Mandragore-ai/fiducial-dice-research/assets/APERCU_8_DES.png

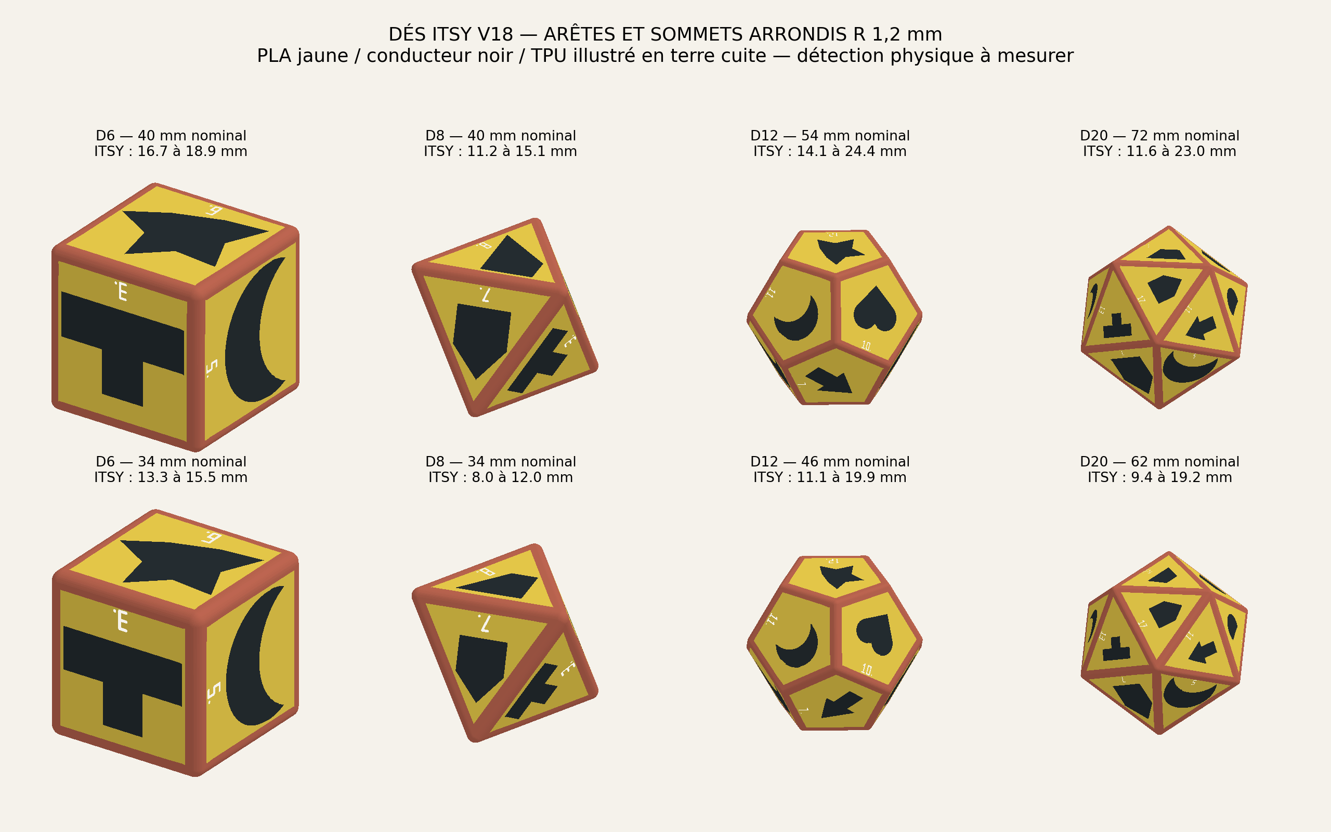
assets/APERCU_8_DES.png
