Mandragore-ai/fiducial-dice-research/docs/face-maps/V18_D6_34_A_FACES.png

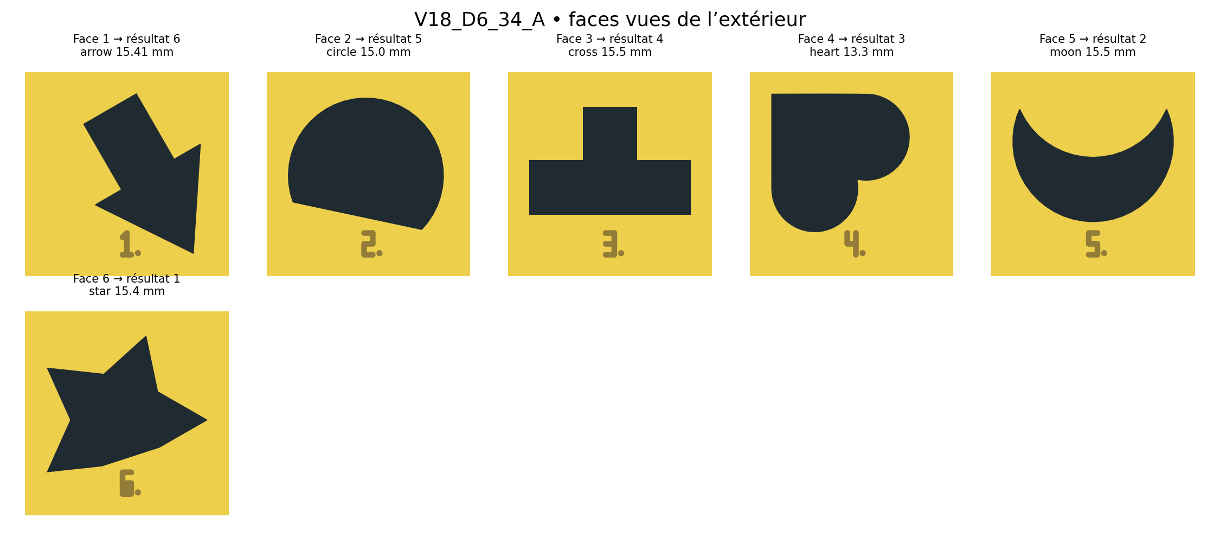
docs/face-maps/V18_D6_34_A_FACES.png
