Mandragore-ai/fiducial-dice-research/docs/face-maps/V18_D8_34_A_FACES.png

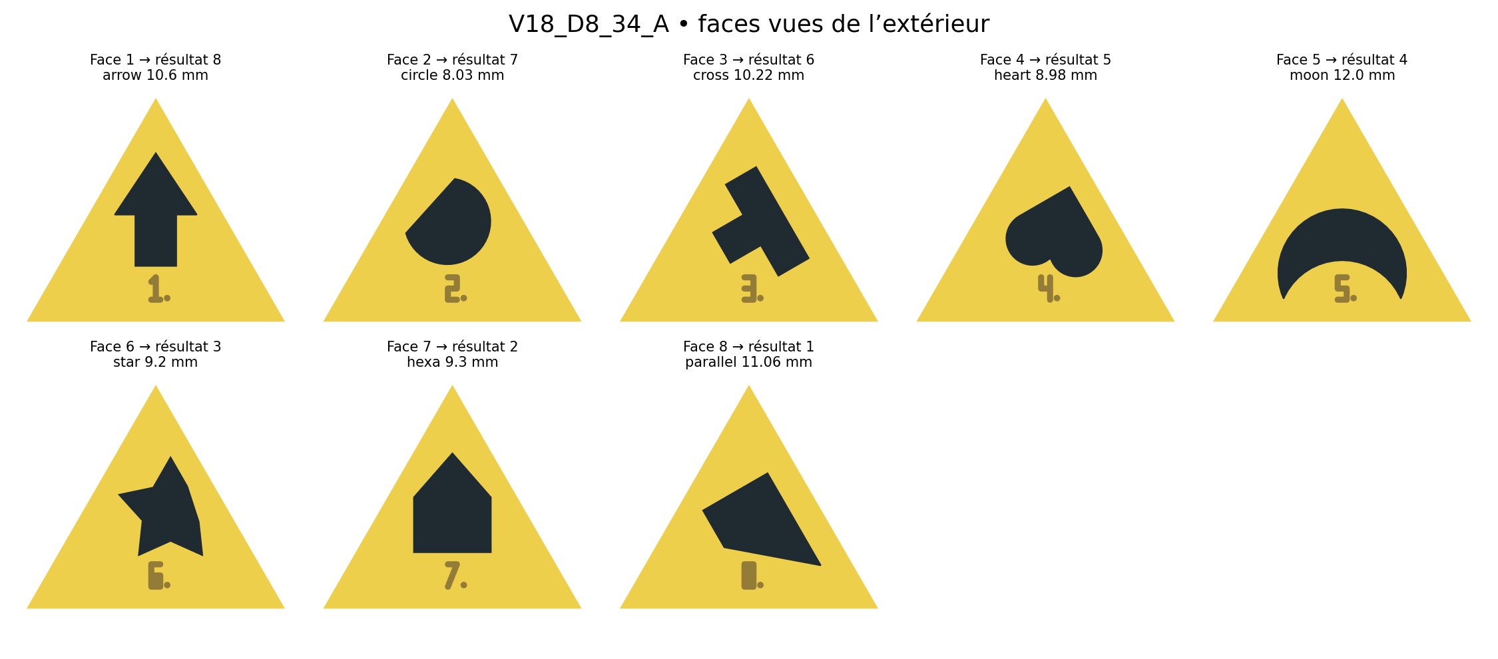
docs/face-maps/V18_D8_34_A_FACES.png
