Mandragore-ai/fiducial-dice-research/docs/face-maps/V18_D12_46_A_FACES.png

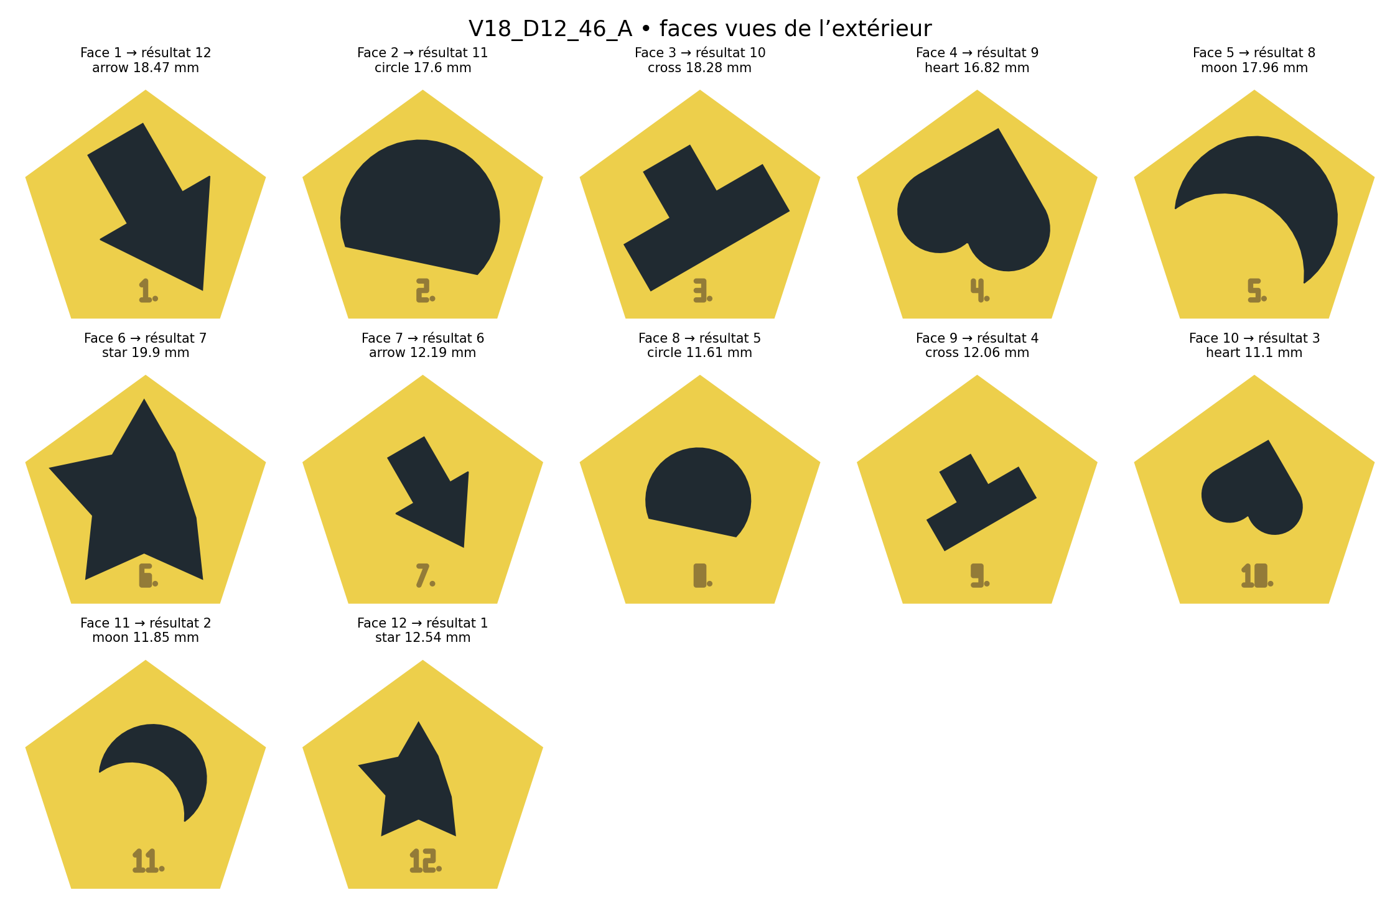
docs/face-maps/V18_D12_46_A_FACES.png
