Mandragore-ai/fiducial-dice-research/docs/face-maps/V18_D20_62_A_FACES.png

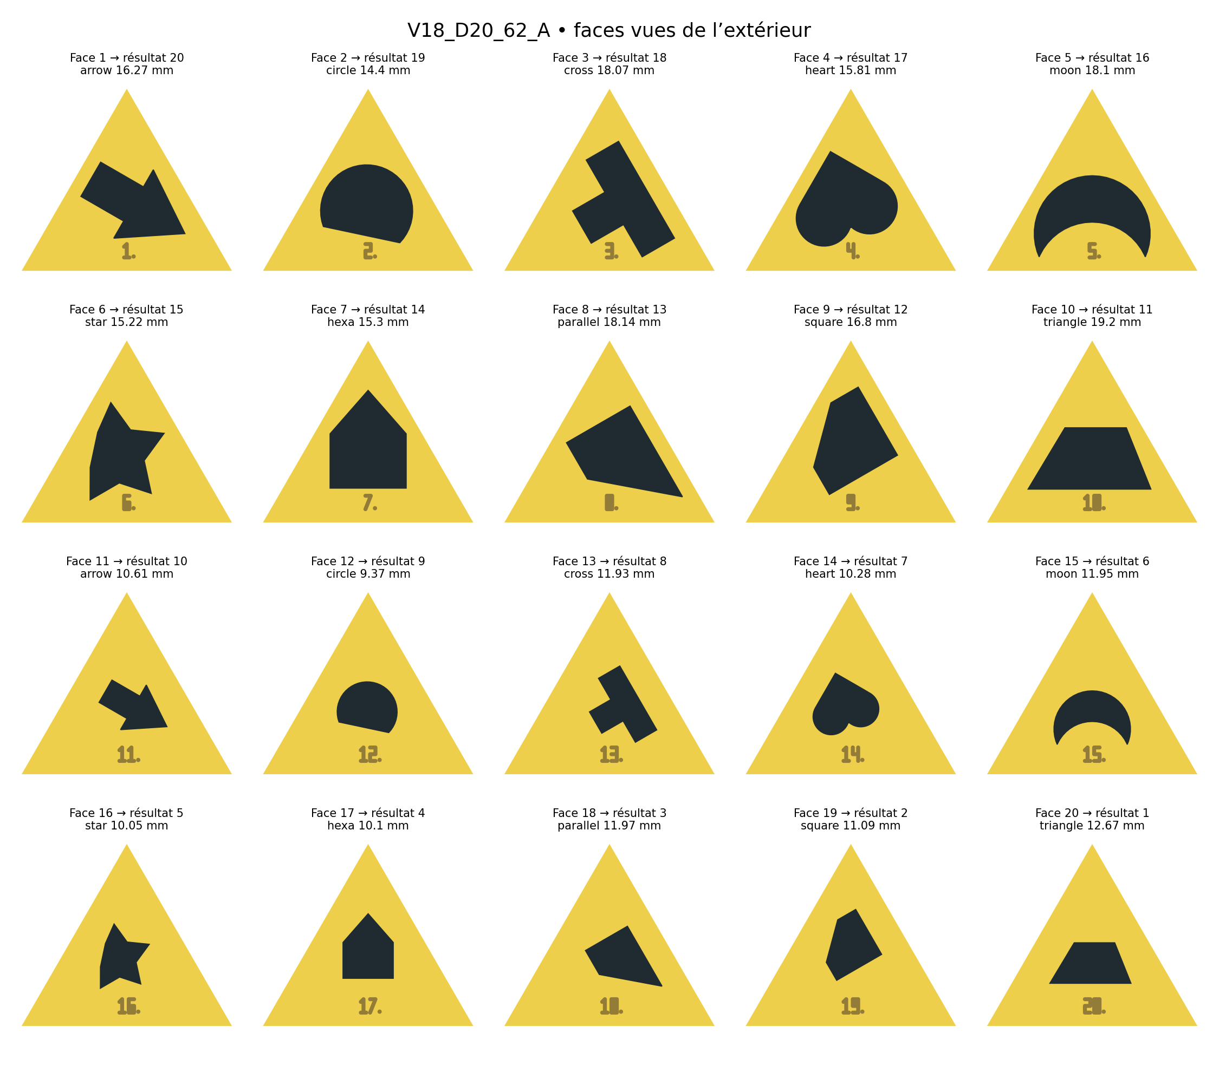
docs/face-maps/V18_D20_62_A_FACES.png
