Mandragore-ai/fiducial-dice-research/docs/catalogue.csv

modele | type | diametre_nominal_mm | diametre_reel_mm | largeur_mm | profondeur_mm | hauteur_mm | rayon_arrondi_mm | fiducial_min_mm | fiducial_max_mm | validation_physique
V18_D6_40_A | D6 | 40 | 38.233 | 23.094 | 23.094 | 23.094 | 1.2 | 16.7 | 18.9 | False
V18_D8_40_A | D8 | 40 | 38.243 | 30.666 | 30.668 | 23.094 | 1.2 | 11.2 | 15.1 | False
V18_D12_54_A | D12 | 54 | 53.369 | 52.475 | 50.024 | 42.911 | 1.2 | 14.12 | 24.4 | False
V18_D20_72_A | D20 | 72 | 71.38 | 61.078 | 70.152 | 57.215 | 1.2 | 11.55 | 23.01 | False
V18_D6_34_A | D6 | 34 | 32.233 | 19.63 | 19.63 | 19.63 | 1.2 | 13.3 | 15.5 | False
V18_D8_34_A | D8 | 34 | 32.243 | 25.934 | 25.936 | 19.63 | 1.2 | 8.03 | 12.0 | False
V18_D12_46_A | D12 | 46 | 45.37 | 44.617 | 42.551 | 36.554 | 1.2 | 11.1 | 19.9 | False
V18_D20_62_A | D20 | 62 | 61.38 | 52.571 | 60.33 | 49.269 | 1.2 | 9.37 | 19.2 | False
