Mandragore-ai/fiducial-dice-research/models/ETAPE_2_ARRONDIS_34_34_46_62mm.3mf

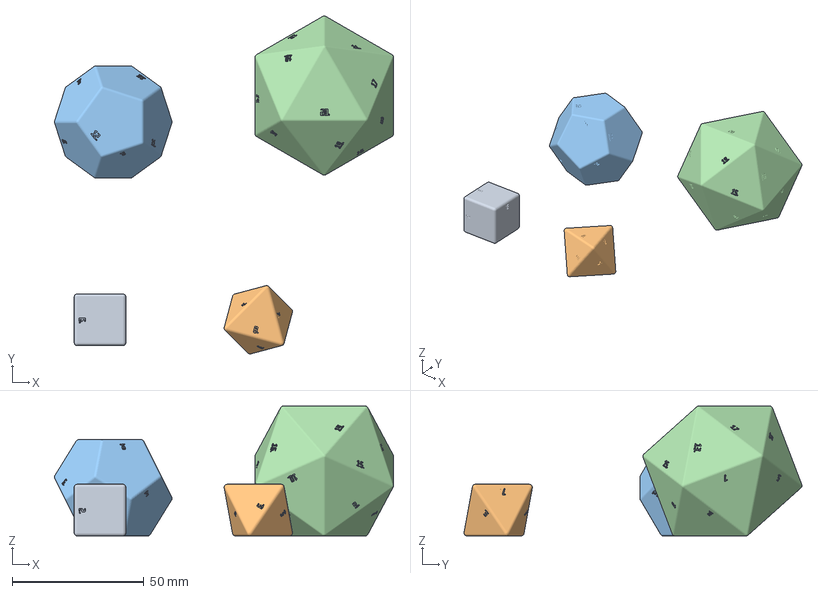
[picture p6: CAD file, 2026-11-07]
models/ETAPE_2_ARRONDIS_34_34_46_62mm.3mf
128.6 x 128.1 x 49.3 mm
V18_D6_34_A
V18_D8_34_A
V18_D12_46_A
V18_D20_62_A
