Mandragore-ai/fiducial-dice-research/models/individuels/V18_D8_40_A.3mf

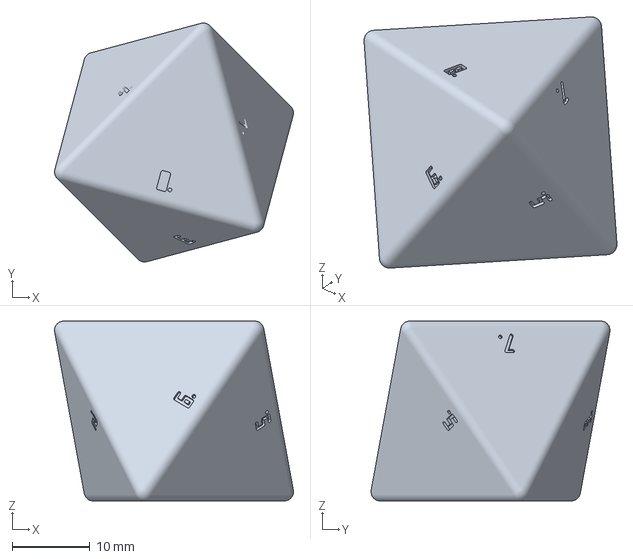
[picture p7: CAD file, 2026-11-07]
models/individuels/V18_D8_40_A.3mf
30.7 x 30.7 x 23.1 mm
