Mandragore-ai/fiducial-dice-research/models/01_REFERENCE_VERIFIEE_BAMBU.3mf

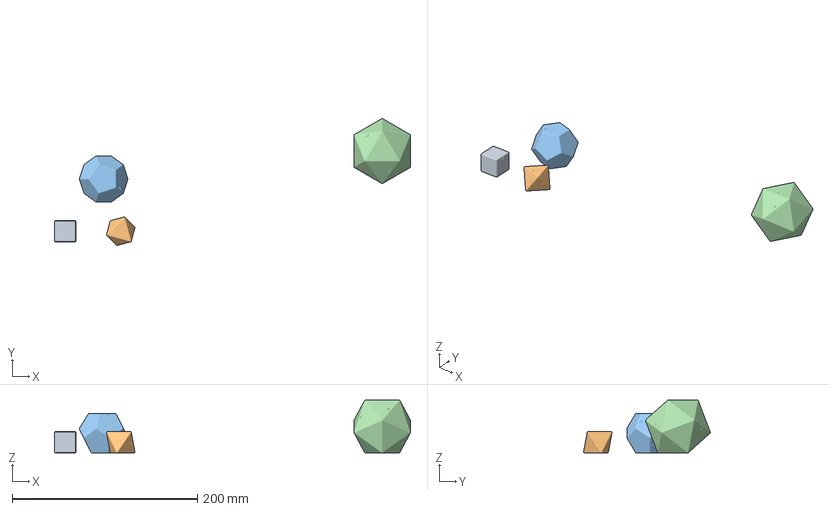
[picture p8: CAD file, 2026-11-07]
models/01_REFERENCE_VERIFIEE_BAMBU.3mf
384.6 x 137.0 x 57.2 mm
V18_D6_40_A
V18_D8_40_A
V18_D12_54_A
V18_D20_72_A
