Mandragore-ai/fiducial-dice-research/models/individuels/V18_D6_40_A.3mf

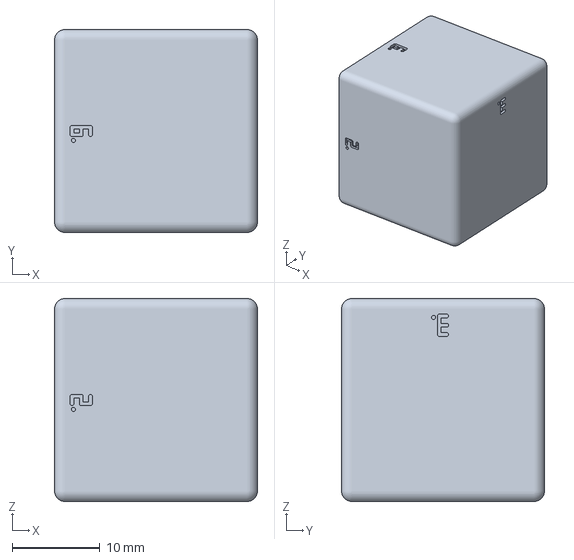
[picture p9: CAD file, 2026-11-07]
models/individuels/V18_D6_40_A.3mf
23.1 x 23.1 x 23.1 mm
