Mandragore-ai/fiducial-dice-research/models/individuels/V18_D12_54_A.3mf

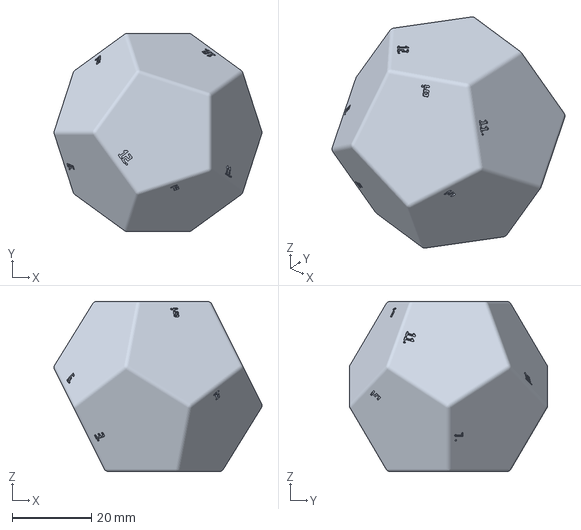
[picture p10: CAD file, 2026-11-07]
models/individuels/V18_D12_54_A.3mf
52.5 x 50.0 x 42.9 mm
