Mandragore-ai/fiducial-dice-research/models/individuels/V18_D6_34_A.3mf

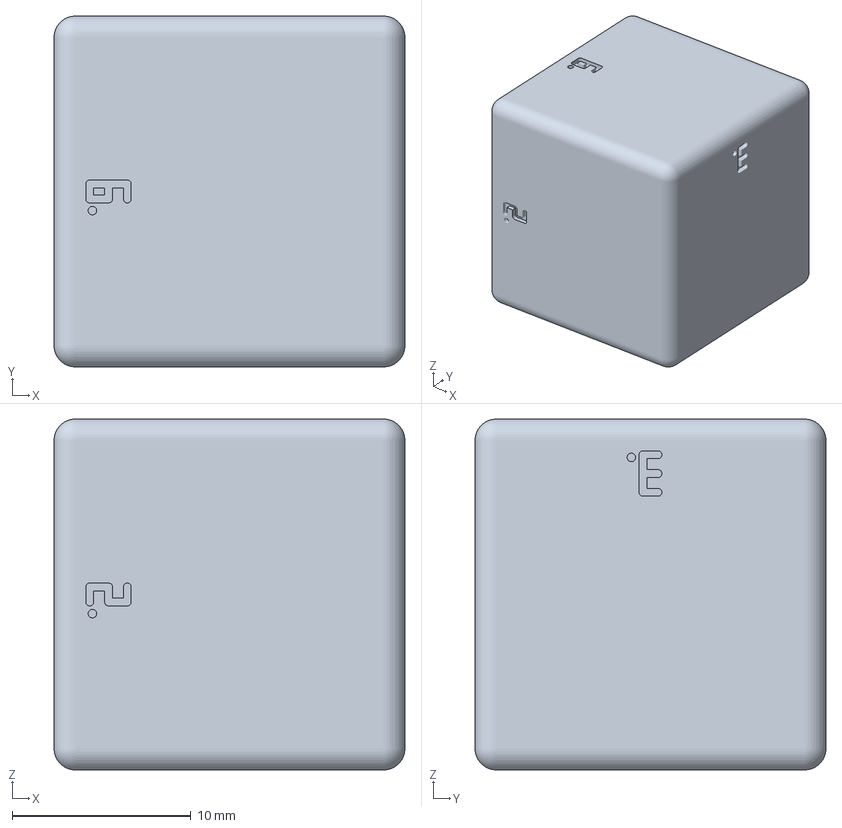
[picture p11: CAD file, 2026-11-07]
models/individuels/V18_D6_34_A.3mf
19.6 x 19.6 x 19.6 mm
