Mandragore-ai/fiducial-dice-research/models/individuels/V18_D20_72_A.3mf

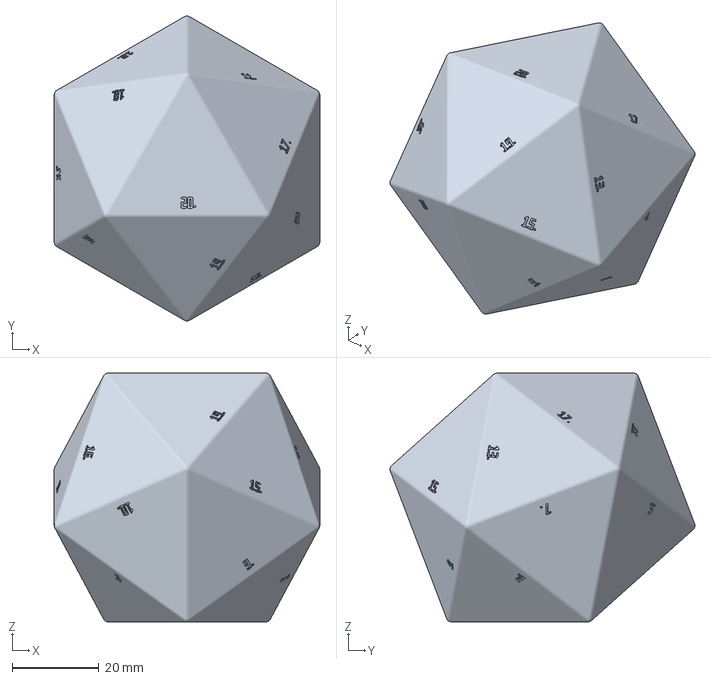
[picture p12: CAD file, 2026-11-07]
models/individuels/V18_D20_72_A.3mf
61.1 x 70.2 x 57.2 mm
