Mandragore-ai/fiducial-dice-research/models/individuels/V18_D20_62_A.3mf

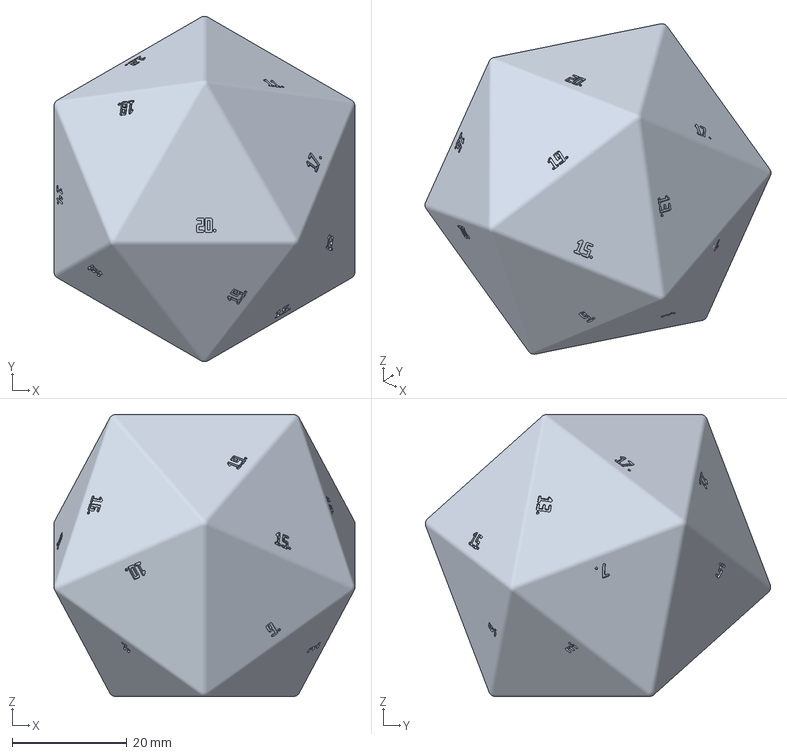
[picture p13: CAD file, 2026-11-07]
models/individuels/V18_D20_62_A.3mf
52.6 x 60.3 x 49.3 mm
