Mandragore-ai/fiducial-dice-research/models/individuels/V18_D8_34_A.3mf

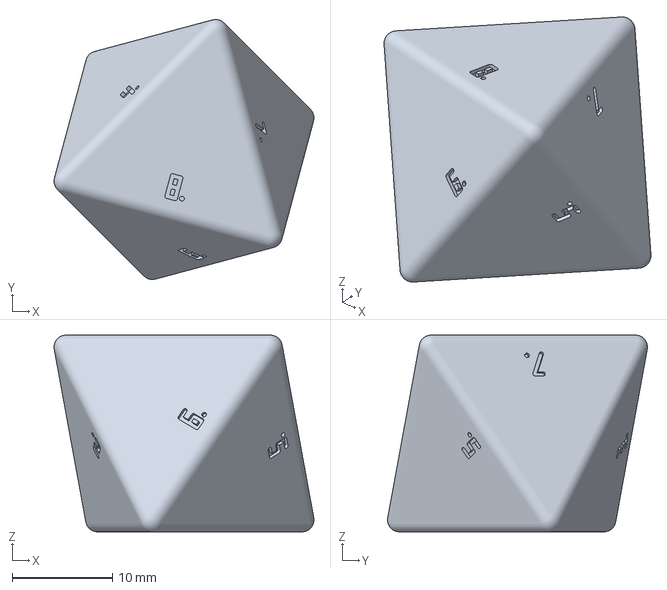
[picture p14: CAD file, 2026-11-07]
models/individuels/V18_D8_34_A.3mf
25.9 x 25.9 x 19.6 mm
