Mandragore-ai/fiducial-dice-research/models/individuels/V18_D12_46_A.3mf

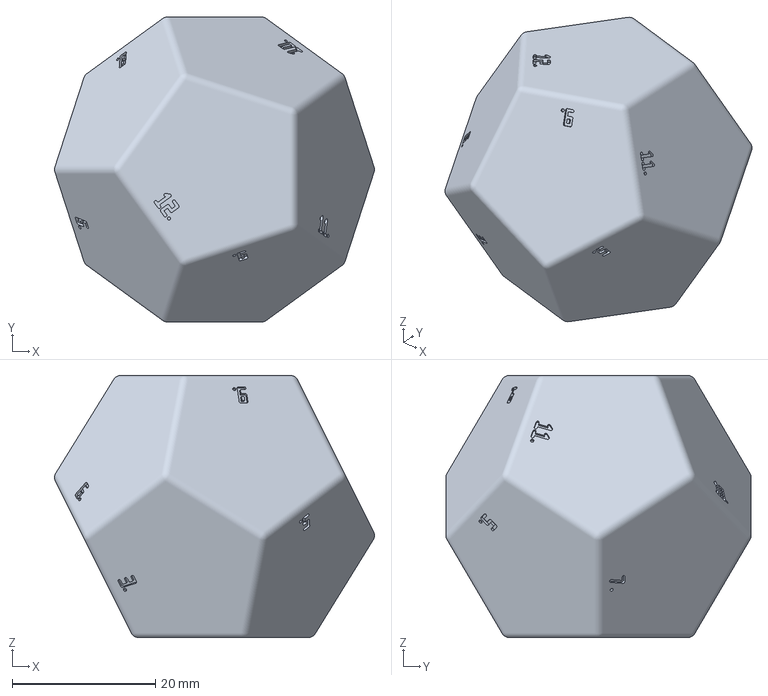
[picture p15: CAD file, 2026-11-07]
models/individuels/V18_D12_46_A.3mf
44.6 x 42.6 x 36.6 mm
